SoumyadeepXD/prosthetic/hardware/diagrams/complete_wiring_diagram.png

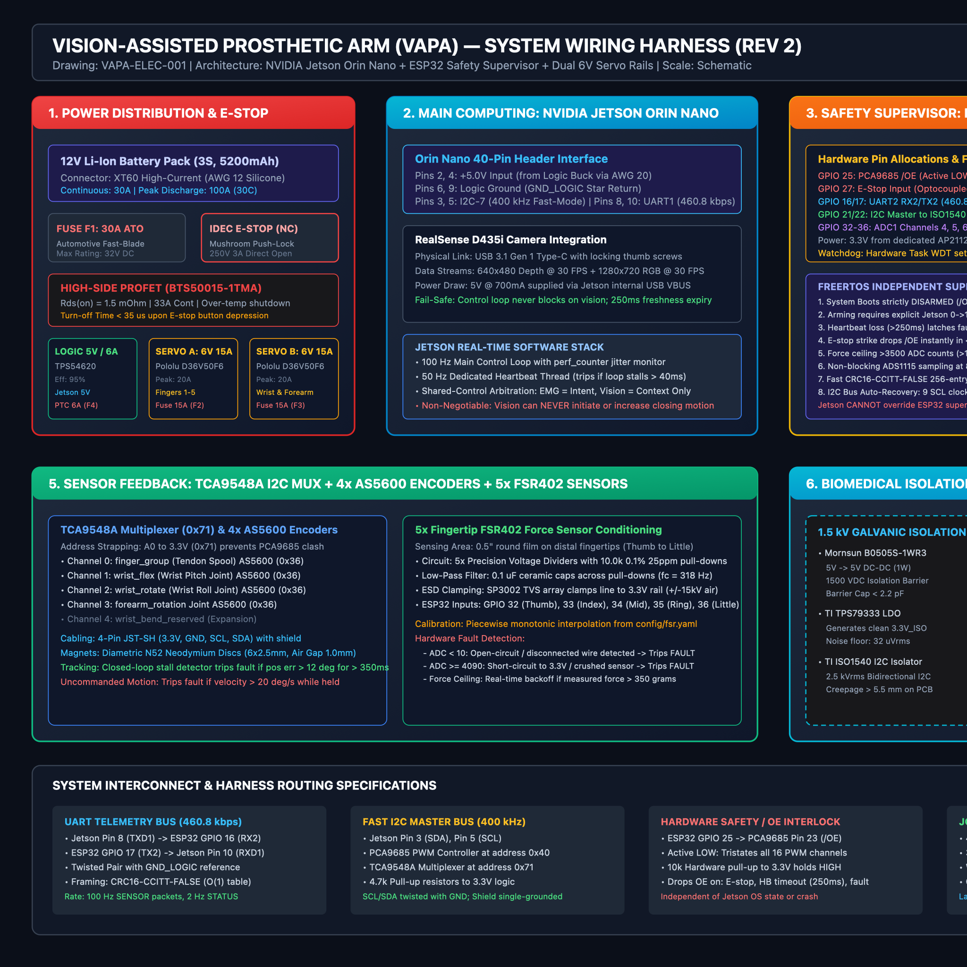
hardware/diagrams/complete_wiring_diagram.png
