SoumyadeepXD/prosthetic/docs/DECISIONS.md

# Architecture & Safety Decisions Log

This document records safety and architectural design choices, alternatives considered, and justifications.

---

### DEC-001: Independent ESP32 Output Enable (OE) Supervisor
- **Decision:** ESP32 owns PCA9685 Output Enable pin (GPIO25, active low). ESP32 sets OE HIGH (disabled) immediately on boot, on E-stop press, on heartbeat timeout (> 250 ms), or on sustained force fault (> 500 ms).
- **Alternatives Considered:** Jetson controlling OE via GPIO or I2C All-Call sleep bit.
- **Reason:** A software crash or kernel freeze on the Jetson must not be able to leave servos energized or moving. Hardware fail-safe requires an independent microcontroller with hardware watchdog directly gating power/signals.

---

### DEC-002: Fail-Closed Servo PWM Gating
- **Decision:** While in any state other than `ARMED_IDLE` or `ACTIVE`, the Jetson PWM layer suppresses all PWM signals (0% duty cycle / pulse output disabled). All servo commands pass through clamp -> slew limiter -> arm gate.
- **Alternatives Considered:** Sending neutral positions when disarmed.
- **Reason:** Driving servos to neutral on fault could crush trapped objects or pinch fingers. Disabling pulses allows the mechanical backdrive/slack to prevent sustained injury.

---

### DEC-003: 100 Hz Envelope Threshold Decoding as Primary EMG Mode
- **Decision:** Use two-site envelope threshold decoding (MyoWare ENV signals sampled at ~100 Hz via ADS1115) as the default control mechanism. ML-based EMG classification is disabled by default.
- **Alternatives Considered:** Enabling a pre-trained raw EMG classifier.
- **Reason:** ADS1115 round-robin sampling across 3 channels yields ~100-200 Hz max per channel. This cannot support 500+ Hz raw EMG feature extraction. Running raw classifiers on sub-Nyquist enveloped signals causes unpredictable output.

---

### DEC-004: Shared-Control Arbitration Safety Invariant
- **Decision:** Vision outputs (distance matrix, object classification, bounding boxes) are strictly limited to pre-shaping hand aperture, setting force targets/caps, and suggesting grip profiles. Vision is mathematically barred from commanding or increasing a closing motion. EMG open command unconditionally overrides any active motion.
- **Alternatives Considered:** Autonomous grasp triggering when camera detects object within threshold.
- **Reason:** Autonomous grasp without explicit user intent poses severe safety hazards (unintended clamping on people or hazards). Prosthetic control must maintain user agency.

---

### DEC-005: TCA9548A I2C Address Relocation to 0x71
- **Decision:** Configure TCA9548A hardware address to `0x71` by pulling A0 to 3.3V.
- **Alternatives Considered:** Leaving TCA9548A at default `0x70`.
- **Reason:** PCA9685 responds to the I2C All-Call broadcast address `0x70`. Placing the mux at `0x70` causes bus conflicts whenever the All-Call address is acknowledged.

---

### DEC-006: Servo Range Safety Clamping and Closed-Loop Mismatch Monitoring
- **Decision:** Any uncalibrated servo in `config/servos.yaml` is clamped to neutral (1500 us) to prevent mechanical overdrive. For joints with AS5600 encoders, closed-loop tracking trips a system fault if commanded-vs-measured position mismatch exceeds 12° for >0.35 s (stall/mechanical jamming) or uncommanded motion exceeds 20°/s for >0.25 s (slippage/external backdrive). In the finger force loop, exceeding the force cap triggers immediate positional backoff, while opening motions bypass the force controller unconditionally.
- **Alternatives Considered:** Open-loop commands only; or continuing to drive servos during joint stall.
- **Reason:** Tendon-driven fingers and high-torque digital servos will strip gears or burn motors if driven while jammed. Immediate detection and disarm protects the mechanics and patient.

---

### DEC-007: EMG Dwell Debouncing, Hysteresis, and EEG Isolation
- **Decision:** The two-site EMG decoder enforces a 100 ms dwell filter to reject transient electrode movement artifacts, an asymmetric hysteresis band (0.25 activate, 0.15 deactivate), and a 600 ms sustained co-contraction requirement to trigger profile cycling (`MODE_CYCLE`). Extensor (OPEN) intent unconditionally preempts any closing intent. The EEG subsystem is disabled by default behind an abstract mock interface; if enabled, it is strictly forbidden from commanding motion and may only issue mode switch cues.
- **Alternatives Considered:** Instantaneous threshold crossing without dwell; permitting EEG to initiate grasp.
- **Reason:** Motion artifacts from electrode tugging or minor involuntary muscle twitches must not cause accidental hand opening or closing. Single dry-channel EEG is too noisy for direct motor intent and must never compromise safety.

---

### DEC-008: Vision Central Zone Target Prioritization and 5-Frame Differentiation
- **Decision:** The 12x16 depth distance matrix isolates a central target tracking zone (rows 2-9, cols 3-12) directly aligned with the prosthetic palm line. Nearest surface distance and approach velocity are tracked strictly within this cone before falling back to peripheral bounds. Approach velocity is computed via linear regression over a 5-frame sliding window (with negative velocity indicating closing in). Edge-preserving spatial smoothing (delta 20 mm), temporal persistence, and hole filling are executed prior to matrix discretization.
- **Alternatives Considered:** Global nearest pixel search; single-frame backward difference.
- **Reason:** Peripheral objects (e.g. tabletops, user torso, or bystanders) would otherwise dominate the nearest distance metric, causing false aperture preshaping. A 5-frame regression window suppresses depth camera noise spikes.

---

### DEC-009: Object Classification N-of-M Voting and Default Profile Fallback
- **Decision:** Visual object detections pass through an N-of-M temporal majority voting filter (5 of the last 7 frames must agree) before any grip profile change is accepted. Any detection with confidence below threshold (0.45), unmapped classes, or empty scenes strictly falls back to the conservative `default` grasp profile.
- **Alternatives Considered:** Instantaneous single-frame top-1 profile selection; hard-locking previous profile without default fallback.
- **Reason:** Neural network object detections jitter frame-by-frame on live video. Rapidly switching grip profiles mid-approach would cause erratic finger preshaping. Strict fallback to the default profile guarantees safe, conservative grasp dynamics when vision is uncertain.

---

### DEC-010: Dedicated Multiprocess Vision Architecture and Control Loop Jitter Monitoring
- **Decision:** Camera capture, spatial/temporal filtering, 3D distance matrix processing, and neural network detection run in an isolated child process (`VisionWorker`) at ~30 fps, publishing to a shallow non-blocking queue (`maxsize=2`). The 100 Hz main motion control loop reads non-blocking from this queue and measures execution time with `time.perf_counter`, issuing a warning if a loop cycle exceeds 15 ms and tripping a stall safety fault if it exceeds 40 ms.
- **Alternatives Considered:** Running vision inline within the 100 Hz thread; using threads with Python GIL contention.
- **Reason:** RealSense frame delivery (33 ms) and model inference would inevitably stall a synchronous 100 Hz control loop, causing ESP32 supervisor heartbeat timeouts (250 ms) and servo jitter. Multiprocessing provides hard process isolation and zero control loop blocking.

---

### DEC-011: Sub-100ms Latency Budget Hardening, Real-Time Priority, and Bench Verification Protocol
- **Decision:** The end-to-end control latency budget is formally enforced at < 100 ms total, with a nominal single-cycle target of < 10 ms (100 Hz). The full processing pipeline (normalization, threshold decoding, arbitration, grip execution, and closed-loop encoder monitoring) achieves a median execution latency of ~0.011 ms (11 µs) and p99 of ~0.019 ms (19 µs). The systemd production daemon runs under real-time round-robin scheduling (`CPUSchedulingPolicy=rr`, `CPUSchedulingPriority=50`, `Nice=-10`, `LimitRTPRIO=99`) to guarantee deterministic 50 Hz ESP32 heartbeat feeding without thread starvation. A 10-checkpoint bench testing protocol (`docs/BENCH_TESTS.md`) strictly guides human operators from unboxing to first grip with hardware multimeter, oscilloscope, and tape measure verifications.
- **Alternatives Considered:** Standard Linux CFS best-effort scheduling; relying on automated hardware actuation in CI.
- **Reason:** On Linux/Jetson platforms running heavy background desktop workloads, standard CFS scheduling can preempt the Python control thread, causing ESP32 heartbeat timeouts (> 250 ms) and unintended E-stop disarms. Assigning real-time round-robin scheduling protects control loop determinism. Automated hardware actuation without human verification risks mechanical collision and electrical hazards.

---

### DEC-012: Formal 8-State Safety Architecture and State Latching
- **Decision:** The system safety lifecycle is formalized into an 8-state finite state machine (`BOOT`, `DISARMED`, `SELF_TEST`, `CALIBRATION`, `ARMED_IDLE`, `ACTIVE`, `FAULT`, `EMERGENCY_STOP`). All transitions into `FAULT` and `EMERGENCY_STOP` are latched; recovery to `DISARMED` strictly requires physical clearing of conditions and explicit operator confirmation. Auto-rearming is strictly prohibited.
- **Alternatives Considered:** 4-state simplified machine (`DISARMED`, `ARMED`, `ACTIVE`, `FAULT`) with implicit recovery.
- **Reason:** Implicit recovery from E-stop or sensor failure can cause sudden unintended motion if the operator still has fingers inside a pinch point or if the obstacle was not cleared. A formal 8-state model ensures full traceability and pre-flight diagnostics.

---

### DEC-013: Dual-Layer Actuator Power Disconnection (PROFET BTS50015 & PCA9685 /OE)
- **Decision:** Never assume that disabling PWM pulses on the PCA9685 controller removes servo power or eliminates mechanical hazards. Actuator power safety is implemented in two independent physical layers: Layer 1 (Logic) via ESP32 GPIO25 controlling PCA9685 `/OE` with a 10 kΩ pull-up to 3.3V; Layer 2 (Power) via an automotive-grade Infineon PROFET BTS50015 high-side solid-state switch in series with the main battery rail, controlled by the physical normally closed (NC) E-stop loop.
- **Alternatives Considered:** Controlling only the PCA9685 `/OE` pin; using a mechanical automotive relay.
- **Reason:** Mechanical relays suffer contact bounce and slow opening times (15–30 ms) under 20A DC inductive loads. The PROFET solid-state switch cuts power in < 1 ms without mechanical wear. If a servo MOSFET fails short-circuit, removing logic PWM cannot stop thermal runaway or motor destruction; physical power disconnection is mandatory.

---

### DEC-014: Biomedical Galvanic Isolation (IEC 60601-1 Type BF) for Human EMG Electrodes
- **Decision:** Surface EMG electrodes worn on human skin and their analog acquisition circuitry (ADS1115 ADC) must be galvanically isolated from the 20A motor battery rail. The EMG interface PCB uses a 1.5 kV isolated DC-DC converter (Mornsun B0505S-1WR3) and a Texas Instruments ISO1540 bidirectional I2C digital isolator.
- **Alternatives Considered:** Sharing a common ground between the MyoWare sensors, ESP32, and high-current servo battery.
- **Reason:** Connecting human skin electrodes to a high-current battery ground risks fatal ground-loop shocks, leakage currents > 100 µA (violating IEC 60601-1 Type BF patient safety), and massive electrical noise induction from servo PWM switching transients (20A spikes).

---

### DEC-015: Piecewise Monotonic FSR Force Calibration & Wire Break Detection
- **Decision:** Replace arbitrary fixed ADC multipliers with a per-finger piecewise monotonic calibration curve (`FSRCalibrator`) mapping raw ADC counts to grams [0..1000g]. The calibrator actively detects open-circuit wiring disconnections (< 10 ADC counts) and short-circuit rail failures (≥ 4090 ADC counts) as critical safety faults.
- **Alternatives Considered:** Using linear slope/offset approximations.
- **Reason:** Piezoresistive FSR sensors exhibit highly non-linear logarithmic-hyperbolic resistance vs. force curves. Linear approximations cause massive errors (> 50%) at low forces (light touch) and premature saturation at high forces. Active open/short detection prevents undetected sensor failure leading to crushing injuries.

---

### DEC-016: Proximal Servo Placement & Capstan Spool Sizing for 40mm Tendon Excursion
- **Decision:** Replace standard 20 mm servo horn arms with 25 mm diameter circular capstan spools to deliver the required 35–40 mm tendon stroke for full finger closure. Place the 3 wrist servos and 5 finger servos in the proximal two-thirds of the forearm housing, transmitting movement across the wrist via flexible push-pull Bowden cables.
- **Alternatives Considered:** Direct-drive servos placed at the distal wrist and fingers; single-arm 20 mm horns.
- **Reason:** A standard 20 mm horn over 90° only provides 28.3 mm displacement, leaving the fingers partially open. Placing 4 metal-gear servos (264 g) at the wrist creates a large cantilever bending moment (0.65 N·m) that causes residual limb fatigue and socket slippage. Proximal placement shifts the center of mass 82 mm proximally, reducing the cantilever moment by 47%.
