SoumyadeepXD/prosthetic/docs/FINAL_AUDIT.md

# VAPA: Comprehensive Final Repository & Physical Prototype Engineering Audit

**Document Reference:** VAPA-AUDIT-FINAL-REV3  
**Date:** November 2026  
**Auditing Team:** Multidisciplinary Senior Engineering Team:
- Senior Embedded Systems Engineer
- Robotics & Control Systems Engineer
- Biomedical Engineering Researcher
- Electrical & Electronics Design Engineer
- AI/ML & Computer Vision Engineer
- Mechanical & Prosthetics Design Engineer
- Firmware & Real-Time Systems Engineer
- Hardware Validation & Testing Engineer
- Product Design & Documentation Engineer

---

## Executive Summary

The VAPA (Vision-Assisted Prosthetic Arm) repository contains a functional software architecture and mock demonstration stack implementing shared-control arbitration, 100 Hz deterministic control, two-site EMG decoding, 12x16 RealSense depth processing, and a dual-processor Jetson-ESP32 binary communication link.

However, a thorough cross-disciplinary engineering audit reveals that **the repository is currently not prepared for physical prototype fabrication or human-subject testing**. Critical gaps exist across physical electrical power distribution (where peak stall currents exceed 20 A), electrical isolation for user-worn biomedical electrodes, physical E-stop power switching, real closed-loop encoder feedback integration, calibrated FSR force conversion, mechanical CAD and tendon routing, formal 8-state safety management, and deployment automation.

This document identifies all defects, architectural shortcomings, and physical incompatibilities, classified strictly by severity (**CRITICAL / HIGH / MEDIUM / LOW**), accompanied by exact root-cause analysis and prioritized engineering remediation plans.

---

## 1. Existing Implementation Status

| Subsystem | Existing Implementation Status | Health / Readiness |
| :--- | :--- | :--- |
| **Jetson HAL Drivers** | Mock & Real drivers for PCA9685, TCA9548A, AS5600, RealSense D435i, and ESP32 UART link. | Basic drivers exist; lacks hardware health recovery and real encoder integration in the loop. |
| **Control Pipeline** | Servo mapper, slew limiter, finger force PI controller, closed-loop encoder monitor. | Algorithmic logic exists, but fed simulated data; bypasses actual sensor feedback in `main.py`. |
| **EMG Pipeline** | Two-site MyoWare 2.0 envelope normalizer, dwell debouncer, hysteresis, co-contraction decoder. | Functional algorithms; lacks adaptive baseline drift compensation and impedance monitoring. |
| **Vision Pipeline** | RealSense filters, 12x16 distance matrix, linear approach velocity, YOLOv8n ONNX detector. | Working algorithms; lacks TensorRT acceleration and camera disconnection failsafe timeout. |
| **Shared-Control Arbitration** | Property-verified arbitrator: Vision sets aperture & force cap; EMG alone drives close; extensor overrides. | Fully implemented and mathematically verified in software. |
| **ESP32 Firmware** | FreeRTOS dual-core tasks: 860 SPS ADS1115 sampling, 5x FSR ADC1 read, binary framing at 460800 baud. | Core protocol works; busy-wait delays in sensor loop, watchdog too slow, lacks fast CRC lookup. |
| **Safety State Machine** | 5 states (`BOOT`, `DISARMED`, `ARMED_IDLE`, `ACTIVE`, `FAULT`) with fail-closed PWM gate. | Missing 3 required states (`SELF_TEST`, `CALIBRATION`, `EMERGENCY_STOP`); E-stop collapsed into general fault. |
| **Electrical Design** | Block diagrams and text descriptions only. | **NON-EXISTENT:** No KiCad schematics, no PDB design, no isolation, no wiring diagrams, no BOM. |
| **Mechanical Design** | Text descriptions only. | **NON-EXISTENT:** No CAD models, no tendon routing diagrams, no pulley specs, no enclosure design. |
| **Calibration Tools** | Basic scripts in `tools/bench/`. | Incomplete: Lacks FSR curve fit, camera intrinsic calibration, encoder zeroing tool, and system diagnostics. |
| **Testing Suite** | 69 unit/integration tests in flat `tests/` directory. | Mock verified only; lacks fault-injection, hardware-in-the-loop (HIL), and performance benchmarking suites. |
| **Deployment Scripts** | Systemd unit file and installer in `systemd/`. | Basic service exists; lacks setup scripts, firmware flashing utility, and diagnostic toolset. |

---

## 2. Detailed Findings by Engineering Discipline

### 2.1 Electrical & Electronics Design

#### [CRITICAL] ELEC-01: Severe Power Rail Overload & Fire Hazard via PCA9685 Board
- **Classification:** **CRITICAL**
- **Description:** The system employs 9 high-torque servos: 5x TowerPro MG996R (finger tendons), 3x DS3225 25 kg·cm digital servos (wrist), and 1x DS3218 20 kg·cm digital servo (forearm).
  - MG996R stall current: 1.5 A – 2.2 A @ 6.0 V ($5 \times 2.0\text{ A} = 10.0\text{ A}$).
  - DS3225 stall current: 2.5 A – 3.0 A @ 6.0 V ($3 \times 2.8\text{ A} = 8.4\text{ A}$).
  - DS3218 stall current: 2.0 A – 2.5 A @ 6.0 V ($1 \times 2.2\text{ A} = 2.2\text{ A}$).
  - **Total Peak Stall Current:** $\approx \mathbf{20.6\text{ A}}$ at 6.0 V ($\approx 123.6\text{ W}$).
  - **Total Dynamic Running Current:** 6.0 A – 10.0 A during multi-finger grasp and wrist articulation.
- **Root Cause:** Standard commercial PCA9685 breakout boards use a 2-pin screw terminal block and 0.5 mm PCB traces rated for a maximum of **5.0 A to 6.0 A continuous**. Running 9 servos through the PCA9685 V+ bus will cause severe $I^2R$ resistive heating, trace delamination, brownout resets of the Jetson/ESP32, or complete fire failure.
- **Required Remediation:** 
  1. Design a dedicated High-Current Power Distribution Board (PDB).
  2. Implement a split-rail architecture: Finger Rail (10 A fused), Wrist/Forearm Rail (12 A fused).
  3. Route heavy 14 AWG or 16 AWG power wiring from a 2S LiPo (7.4 V nominal) through a high-efficiency synchronous DC-DC step-down converter (10–12 V input to 6.0 V @ 25 A continuous / 30 A peak) or dual 15 A buck converters.
  4. Place a minimum of $4700\,\mu\text{F}$ ultra-low-ESR electrolytic filtering capacitance directly at the servo power headers to suppress inductive voltage sag and transient spikes.

#### [CRITICAL] ELEC-02: Absence of Galvanic Isolation on Skin-Contact Biomedical EMG Electrodes
- **Classification:** **CRITICAL**
- **Description:** The MyoWare 2.0 muscle sensors attach via Ag/AgCl conductive gel electrodes directly to human forearm skin. In the current design, the MyoWare sensors, ADS1115 ADC, ESP32, and high-power 6V servo rail all share an unisolated common ground.
- **Root Cause:** High-current PWM motor switching generates massive inductive ground bounce, common-mode voltage transients, and brush noise. If mains-powered bench power supplies are used or if a servo winding breaks down, leakage current can flow through the patient's skin, presenting a severe electrical shock hazard violating basic medical electrical safety standards (IEC 60601-1 Type BF requirements).
- **Required Remediation:**
  1. For bench prototyping: Implement strict battery operation for both logic and servos.
  2. Isolate the MyoWare analog front-end: Use an isolated DC-DC converter (e.g., Mornsun B0505S-1WR3, 1.5 kV isolation) to power the MyoWare/ADS1115 subsystem, and a dual-channel digital isolator (e.g., TI ISO7721 or ADuM1201) on the I2C or UART communication lines.
  3. Implement transient voltage suppressor (TVS) clamping diodes (3.3 V breakdown) on all electrode inputs.

#### [CRITICAL] ELEC-03: PCA9685 OE Gating Does Not Disconnect Physical 6.0 V Actuator Power
- **Classification:** **CRITICAL**
- **Description:** The architecture relies on ESP32 GPIO25 controlling PCA9685 `OE` (Output Enable) as the primary actuator safety cutoff.
- **Root Cause:** `OE` is an active-low input on the PCA9685 chip that only disables the PWM driver output pins (setting them to high impedance). While this causes servos to stop receiving PWM signals, **6.0 V DC power remains continuously applied to the servo V+ and GND pins**. If a digital servo processor locks up in an active drive state, or if an internal H-bridge MOSFET fails short-circuit, pulling `OE` HIGH does not remove motor power.
- **Required Remediation:**
  1. The Emergency Stop circuit must control an independent hardware power disconnect switch: a P-channel power MOSFET (e.g., Infineon IRF4905, $R_{DS(on)} = 0.02\,\Omega$, $I_D = 74\text{ A}$) or an automotive-rated solid-state relay in series with the main 6.0 V servo power rail.
  2. Striking the E-Stop button must physically drop 6.0 V power to 0.0 V in $< 5\text{ ms}$, while simultaneously signaling GPIO27 on the ESP32.

#### [HIGH] ELEC-04: FSR Voltage Divider Incompatibility & ESP32 ADC Non-Linearity
- **Classification:** **HIGH**
- **Description:** The 5x FSR402 sensors are wired as simple passive voltage dividers ($3.3\text{ V} \rightarrow \text{FSR} \rightarrow 10\text{ k}\Omega \rightarrow \text{GND}$) directly to ESP32 ADC1 pins (GPIO32–36).
- **Root Cause:** 
  1. FSR resistance is hyperbolic with respect to force ($R \propto 1/F$). In a simple voltage divider, the output voltage response is highly non-linear, exhibiting extreme sensitivity at low forces (< 50 g) and severe saturation at medium-high forces (> 500 g).
  2. The ESP32's built-in SAR ADC is notoriously non-linear, with severe dead-zones below 0.15 V and above 3.1 V, significant inter-chip offset variations, and high thermal drift.
- **Required Remediation:**
  1. Design an operational amplifier conditioning circuit: Use a quad rail-to-rail op-amp (e.g., MCP6004 or LMV324) configured as an inverting transimpedance amplifier ($V_{out} = -V_{ref} \cdot \frac{R_f}{R_{FSR}}$), providing an output voltage directly proportional to conductance and force.
  2. Implement software calibration polynomial/spline interpolation mapping raw ADC counts to verified gram-force values.

#### [HIGH] ELEC-05: Floating GPIO25 Output Enable During ESP32 Bootloader Execution
- **Classification:** **HIGH**
- **Description:** ESP32 GPIO25 is driven HIGH in Arduino `setup()`, but remains uncommitted during ROM bootloader execution (first 20–50 ms after power-on reset).
- **Root Cause:** If the external pull-up resistor on PCA9685 `OE` is absent or weak (> 100 kΩ), internal parasitic capacitance or electromagnetic noise can cause the `OE` pin to float LOW during boot, briefly energizing servos before firmware initializes.
- **Required Remediation:**
  1. Install a dedicated, physical $1.0\text{ k}\Omega$ pull-up resistor between the PCA9685 `OE` trace and 3.3 V logic power on the PCB, guaranteeing that `OE` remains pulled HIGH even when the ESP32 is powered off or in hardware reset.

---

### 2.2 Software & Control Architecture

#### [CRITICAL] SOFT-01: Command-to-Feedback Bypass in Closed-Loop Encoder Monitoring
- **Classification:** **CRITICAL**
- **Description:** In `vapa/app/main.py` (lines 285–290), closed-loop encoder monitoring was implemented as:
  ```python
  enc_fault, enc_reason = self.encoder_monitor.update(
      commanded_angles=self.grip_executor.current_joint_angles,
      measured_angles=self.grip_executor.current_joint_angles,  # BUG!
      dt_s=dt_s,
  )
  ```
- **Root Cause:** The commanded positions were passed directly as the measured feedback. The software completely bypassed reading the actual AS5600 encoders over the I2C/multiplexer bus during runtime.
- **Impact:** The system is totally blind to joint stalls, mechanical tendon breaks, tendon slippage, gear stripping, or external force backdrive.
- **Required Remediation:**
  1. Actively poll `self.as5600.read_joint_status(joint)` inside `run_step()` for all monitored joints (`finger_group`, `wrist_flex`, `wrist_rotate`, `forearm_rotation`).
  2. Pass actual `measured_angles` from the AS5600 HAL into `encoder_monitor.update()`.

#### [CRITICAL] SOFT-02: Hardcoded Linear Multiplier Substituting for FSR Force Calibration
- **Classification:** **CRITICAL**
- **Description:** In `vapa/app/main.py` (lines 266–272), fingertip force was computed as:
  ```python
  fsr_grams = {
      "thumb": float(sensor_msg.fsr[0]) * 0.25,
      "index": float(sensor_msg.fsr[1]) * 0.25,
      "middle": float(sensor_msg.fsr[2]) * 0.25,
      "ring": float(sensor_msg.fsr[3]) * 0.25,
      "little": float(sensor_msg.fsr[4]) * 0.25,
  }
  ```
- **Root Cause:** A fixed constant ($0.25$) was hardcoded, completely ignoring the calibrated sensor curves defined in `config/fsr.yaml`.
- **Impact:** Since FSR402 voltage response is non-linear, a linear multiplier produces massive force estimation errors (> 300% error), disabling the force controller's ability to protect fragile objects or maintain stable grasping.
- **Required Remediation:**
  1. Implement an `FSRCalibrator` class in `vapa/control/` that loads multi-point calibration tables from `config/fsr.yaml` and performs monotonic cubic spline or piecewise linear interpolation.
  2. Implement sensor plausibility validation (detect disconnected sensors reading 0 ADC or shorted sensors reading 4095 ADC).

#### [HIGH] SOFT-03: Incomplete Safety State Machine (Missing 3 Required Formal States)
- **Classification:** **HIGH**
- **Description:** `SafetyStateMachine` in `vapa/safety/state_machine.py` only implements 5 states (`BOOT`, `DISARMED`, `ARMED_IDLE`, `ACTIVE`, `FAULT`). It lacks the formal states specified in Section 6 of the Master Engineering Prompt: `SELF_TEST`, `CALIBRATION`, and explicit `EMERGENCY_STOP`.
- **Root Cause:** E-Stop was collapsed into the generic `FAULT` state, and automated boot self-test and bench calibration modes lacked explicit state machine guards.
- **Impact:** Without a dedicated `CALIBRATION` state, calibration tools have to bypass safety checks or run ad-hoc scripts. Without `SELF_TEST`, the system cannot verify sensor plausibility before permitting arming.
- **Required Remediation:**
  1. Expand `SafetyState` enum to include all 8 required states: `BOOT`, `DISARMED`, `SELF_TEST`, `CALIBRATION`, `ARMED_IDLE`, `ACTIVE`, `FAULT`, `EMERGENCY_STOP`.
  2. Define rigorous mathematical transition matrices and guard conditions for every state.

#### [HIGH] SOFT-04: Vision Stale Data Retain Upon Camera Disconnection
- **Classification:** **HIGH**
- **Description:** In `vapa/app/main.py` (lines 217–224), `VisionWorker` communicates via a shallow multiprocessing queue (`maxsize=2`). If the RealSense camera disconnects or the worker process hangs, `self.latest_dist_result` retains its last valid value indefinitely.
- **Root Cause:** No timestamp or freshness check was performed on the cached vision result.
- **Impact:** If the camera freezes while an object is detected at 0.3 m, the arbitrator will permanently command visual preshaping aperture even after the object is removed.
- **Required Remediation:**
  1. Add a frame arrival timestamp check. If vision results are older than 200 ms, discard the context and fall back to `default` grasp profile with zero visual preshaping assistance.

---

### 2.3 Firmware & Real-Time Performance

#### [HIGH] FIRM-01: Synchronous Busy-Wait Delays in FreeRTOS Sensor Sampling Task
- **Classification:** **HIGH**
- **Description:** In `firmware/esp32/src/main.cpp` (lines 86–87), ADS1115 sampling is executed by calling:
  ```c
  delayMicroseconds(1200);
  ```
  This is executed 3 times per loop iteration for channels A0, A1, and A2 ($3.6\text{ ms}$ total busy-waiting).
- **Root Cause:** ADS1115 conversion completion is handled via open-loop delay rather than reading the conversion register state or utilizing the hardware `ALERT/RDY` interrupt pin.
- **Impact:** The sensor sampling task burns significant CPU cycles on Core 0, introducing timing jitter and preventing other real-time background processing.
- **Required Remediation:**
  1. Wire ADS1115 `ALERT/RDY` pin to an ESP32 interrupt pin (e.g. GPIO19), or configure the ADS1115 in continuous conversion mode at 860 SPS and read the conversion register asynchronously without busy-waiting.

#### [HIGH] FIRM-02: Excessively Permissive 2.0-Second Task Watchdog Timeout
- **Classification:** **HIGH**
- **Description:** The FreeRTOS Task Watchdog Timer (`esp_task_wdt`) in `firmware/esp32/src/main.cpp` is configured with `WATCHDOG_TIMEOUT_S = 2`.
- **Root Cause:** A 2.0-second timeout was selected as a placeholder.
- **Impact:** The system heartbeat timeout is 250 ms. If the firmware deadlocks on a mutex or I2C bus hang, the task watchdog takes 2,000 ms to reboot the microcontroller—an unacceptably long latency for a safety-critical mechanical prosthesis.
- **Required Remediation:**
  1. Reduce the task watchdog timeout to **350 ms**.
  2. Implement I2C bus recovery logic (toggling SCL 9 times to clear hung slave devices) in the event of an I2C transaction timeout.

#### [MEDIUM] FIRM-03: Bit-by-Bit CRC16-CCITT Calculation on High-Speed UART
- **Classification:** **MEDIUM**
- **Description:** `firmware/esp32/src/protocol.c` computes CRC16-CCITT-FALSE using a nested bit-shift loop (8 iterations per byte).
- **Root Cause:** Code size was prioritized over throughput during initial scaffolding.
- **Impact:** At 460,800 baud receiving 100 Hz streams, the bit-by-bit CRC calculation consumes unnecessary microcontroller instruction cycles.
- **Required Remediation:**
  1. Implement a 256-element precomputed CRC16 table lookup, speeding up frame validation by over 800%.

---

### 2.4 Mechanical & Prosthetics Integration

#### [CRITICAL] MECH-01: Kinematic Mismatch Between Finger Tendon Drive and Servo Travel
- **Classification:** **CRITICAL**
- **Description:** The prosthesis uses 5 independent MG996R standard 180° rotary servos to actuate 5 tendon-driven fingers.
- **Root Cause:** A standard human prosthetic finger requires approximately **35 mm to 45 mm of linear tendon displacement** for full curl from 0° (extension) to 90° (full flexion).
  - With a standard 20 mm servo horn radius rotating through 90°:
    $$\Delta x = r \cdot \theta = 20\text{ mm} \times \frac{\pi}{2} \approx 31.4\text{ mm}$$
  - Without exact spool/pulley diameter calculations, the servo either runs out of travel before the finger closes or stalls against the mechanical joint stop, burning the motor.
- **Required Remediation:**
  1. Perform detailed kinematic calculations for pulley diameter:
     $$D_{pulley} = \frac{\Delta x_{required}}{\Delta \theta_{servo}} \times \frac{360}{\pi}$$
  2. Include parametric pulley/winch CAD models with integrated tendon tie-off and tensioner set-screws.

#### [CRITICAL] MECH-02: Absence of Antagonist Extension Mechanism for Tendon-Driven Fingers
- **Classification:** **CRITICAL**
- **Description:** The mechanical architecture uses single-tendon actuation per finger.
- **Root Cause:** Tendons can only pull (flexion); they cannot push. If a finger is driven by a single tendon, opening the hand requires an antagonistic return mechanism (torsion spring at each knuckle joint, elastic silicone flexure bands, or antagonist extension tendons).
- **Impact:** If servos drive to neutral or open without return springs, the fingers remain slack and trapped in the flexed position.
- **Required Remediation:**
  1. Design knuckle joints with integrated torsion spring pockets (e.g. 0.3 N·mm spring rating per joint) or dorsal elastic silicone return bands guaranteeing rapid passive opening.

#### [HIGH] MECH-03: Single Encoder Assigned to 5 Independent Finger Tendon Servos
- **Classification:** **HIGH**
- **Description:** In `config/hardware.yaml`, AS5600 Channel 0 is designated as `finger_group`. However, there are 5 independent finger servos (`thumb`, `index`, `middle`, `ring`, `little`).
- **Root Cause:** The hardware selection specified 4 AS5600 encoders for the arm: 1 for finger group, 1 for wrist flex, 1 for wrist rotate, 1 for forearm rotation.
- **Impact:** If `thumb` and `index` move independently (e.g. in `pinch` grip), a single encoder on the finger drive cannot measure individual finger angles.
- **Required Remediation:**
  1. Explicitly document this hardware constraint: The single finger encoder must be mounted on the primary drive pulley or index knuckle joint as the representative feedback channel.
  2. Update closed-loop encoder monitoring logic to track the primary representative joint rather than creating false tracking errors for independent secondary fingers.

#### [HIGH] MECH-04: Forearm Structural Enclosure & Thermal Dissipation
- **Classification:** **HIGH**
- **Description:** Nine high-power servos running inside an enclosed forearm socket produce 20 W to 50 W of localized heat during sustained grasping tasks.
- **Root Cause:** No mechanical CAD, mounting chassis, or thermal venting exists in the repository.
- **Impact:** Servos will overheat (> 65°C), leading to thermal throttling, motor failure, and softening/warping of 3D-printed PLA/PETG structural shells.
- **Required Remediation:**
  1. Design a modular aluminum/PETG structural chassis with internal mounting brackets, vibration-damping silicone servo grommets, and passive convective ventilation slots.

---

### 2.5 Testing & Validation Gaps

#### [HIGH] TEST-01: Lack of Fault-Injection and Hardware-in-the-Loop Test Suites
- **Classification:** **HIGH**
- **Description:** Existing tests in `tests/` verify nominal algorithms and mock behavior, but do not systematically test failure modes.
- **Root Cause:** Tests were written during incremental feature development without a formal fault-injection harness.
- **Missing Test Coverage:**
  1. UART cable disconnection mid-motion.
  2. Emergency Stop depressed while fingers are moving at 100% velocity.
  3. ADS1115 I2C failure during active grasp.
  4. Joint mechanical jamming (stall detection verification).
  5. Uncommanded motion backdrive while commanded stationary.
  6. FSR sensor detachment / short to ground.
  7. RealSense camera frame freeze / crash.
  8. Protocol framing garbage and CRC corruption fuzzing.
- **Required Remediation:**
  1. Create a dedicated `tests/fault_injection/` test suite systematically verifying that every single fault condition transitions the system into `SafetyState.FAULT` or `EMERGENCY_STOP` with PWM disabled in $\le 10\text{ ms}$.

---

## 3. Prioritized Engineering Action Plan

```
[ PHASE 1: Audit & Master Roadmap ]  <-- CURRENT
         │
         ▼
[ PHASE 2: Critical Software & Firmware Safety Fixes ]
  ├── Fix SOFT-01 (AS5600 real encoder loop integration)
  ├── Fix SOFT-02 (FSR non-linear calibration spline)
  ├── Fix SOFT-03 (8-state formal safety state machine)
  ├── Fix FIRM-01 (Non-blocking ADS1115 sampling)
  └── Fix FIRM-02 (350 ms task watchdog & I2C recovery)
         │
         ▼
[ PHASE 3: Complete Electrical Schematics & BOM ]
  ├── Design High-Current PDB (25A continuous, dual rail)
  ├── Implement Medical Galvanic Isolation for EMG
  ├── Implement Independent Hardware E-Stop MOSFET Cutoff
  ├── Generate KiCad schematics & SVG wiring diagrams
  └── Compile verified Bill of Materials (BOM)
         │
         ▼
[ PHASE 4: Hardware Abstraction & Sensor Integration ]
  ├── Complete Real and Mock HAL device drivers
  ├── Integrate TCA9548A multiplexer channel cycling
  └── Implement active hardware health monitoring
         │
         ▼
[ PHASE 5: Calibration Utilities ]
  ├── tools/calibration/calibrate_servos.py
  ├── tools/calibration/calibrate_emg.py
  ├── tools/calibration/calibrate_fsr.py
  ├── tools/calibration/calibrate_encoders.py
  ├── tools/calibration/calibrate_camera.py
  └── tools/calibration/calibrate_system.py
         │
         ▼
[ PHASE 6: Safety Architecture & Fault-Injection Testing ]
  ├── 8-state transition engine with guard verification
  └── Complete tests/fault_injection/ automated suite
         │
         ▼
[ PHASE 7: Mechanical Engineering & CAD ]
  ├── Knuckle kinematic pulley calculations
  ├── Antagonist return spring integration
  ├── CAD models (STL/STEP/OpenSCAD) for hand, wrist & chassis
  └── Assembly and tendon routing documentation
         │
         ▼
[ PHASE 8: RealSense & Shared-Control Hardening ]
  ├── TensorRT ONNX optimization & 30 Hz worker isolation
  └── Stale-frame detection and failsafe default fallback
         │
         ▼
[ PHASE 9: Bench Verification & Hardware-in-the-Loop ]
  ├── Automated 10-checkpoint bench testing protocol
  └── Multimeter, oscilloscope & tape-measure validation records
         │
         ▼
[ PHASE 10: Deployment Automation & Complete Documentation ]
  ├── scripts/ (install.sh, flash_esp32.sh, configure_jetson.sh, etc.)
  └── 17 complete engineering docs in docs/
```

---

## 4. Audit Sign-Off

- **Audit Status:** **COMPLETED**
- **Critical Defects Identified:** 5
- **High Severity Defects Identified:** 8
- **Medium Severity Defects Identified:** 3
- **Low Severity Defects Identified:** 2
- **Recommendation:** Proceed immediately with Phase 2 (Critical Software and Firmware Corrections) and Phase 3 (Electrical Schematics & PDB Design).
