SoumyadeepXD/prosthetic/hardware/bom/bill_of_materials.csv

Reference | Component | Manufacturer | Part Number | Package / Footprint | Electrical Specifications | Quantity | Subsystem | Unit Price (USD) | Supplier & Part No | Datasheet URL
U1 | NVIDIA Jetson Orin Nano Developer Kit | NVIDIA | 945-13766-0005-000 | Custom Module / Carrier | 7W - 15W mode; 6-core ARM; 20-40 TOPS; 40-pin GPIO | 1 | Main Computing | 499.00 | Arrow / 945-13766-0005-000 | https://developer.nvidia.com/embedded/jetson-orin-nano-developer-kit
CAM1 | Intel RealSense D435i Depth Camera | Intel | 999AFR | USB-C Enclosure | Active IR Stereo Depth + RGB + BMI055 IMU | 1 | Vision | 349.00 | Mouser / 675-999AFR | https://www.intelrealsense.com/depth-camera-d435i/
U2 | ESP32-WROOM-32E Microcontroller | Espressif Systems | ESP32-WROOM-32E-N4 | SMD Module 18x25.5mm | Dual-core 240MHz Xtensa LX6; 4MB SPI Flash; 3.3V | 1 | Safety Supervisor | 3.85 | DigiKey / 1965-ESP32-WROOM-32E-N4CT-ND | https://www.espressif.com/sites/default/files/documentation/esp32-wroom-32e_esp32-wroom-32ue_datasheet_en.pdf
U3 | PCA9685 16-Channel 12-Bit PWM Controller | NXP Semiconductors | PCA9685PW | TSSOP-28 | I2C Fast Mode+; 12-bit 40-1000Hz PWM; Active-LOW OE | 1 | Actuator Control | 2.45 | DigiKey / 568-10255-1-ND | https://www.nxp.com/docs/en/data-sheet/PCA9685.pdf
U4 | TCA9548A 8-Channel I2C Switch | Texas Instruments | TCA9548APWR | TSSOP-24 | 1.65V to 5.5V Bus; 400kHz; Hardware Reset; Addr 0x71 | 1 | Encoder Bus | 1.80 | DigiKey / 296-36873-1-ND | https://www.ti.com/lit/ds/symlink/tca9548a.pdf
U5 | ADS1115 16-Bit 860SPS 4-Ch Delta-Sigma ADC | Texas Instruments | ADS1115IDGSR | VSSOP-10 | 16-bit; Internal Reference; I2C; 860 samples/sec | 1 | Isolated Sensor | 4.10 | DigiKey / 296-24934-1-ND | https://www.ti.com/lit/ds/symlink/ads1115.pdf
U6 | ISO1540 Bidirectional I2C Digital Isolator | Texas Instruments | ISO1540DR | SOIC-8 | 2.5 kVrms isolation; Bidirectional SCL/SDA; 1MHz | 1 | Biomedical Isolation | 3.25 | DigiKey / 296-30354-1-ND | https://www.ti.com/lit/ds/symlink/iso1540.pdf
U7 | Medical Grade Isolated DC-DC Converter 5V->5V | Mornsun | B0505S-1WR3 | SIP-4 | 5Vin to 5Vout; 1W; 1500 VDC Isolation; 2pF barrier | 1 | Biomedical Isolation | 4.50 | Mouser / Mornsun B0505S-1WR3 | https://www.mornsun-power.com/public/uploads/pdf/B_S-1WR3.pdf
U8 | Low-Dropout 3.3V Voltage Regulator | Diodes Incorporated | AP2112K-3.3TRG1 | SOT-23-5 | Vin up to 6V; Vout 3.3V; 600mA; 250mV Dropout | 1 | ESP32 Logic Power | 0.45 | DigiKey / 31-AP2112K-3.3TRG1CT-ND | https://www.diodes.com/assets/Datasheets/AP2112.pdf
U9 | Isolated Ultra-Low-Noise 3.3V LDO | Texas Instruments | TPS79333DBVR | SOT-23-5 | Vin up to 5.5V; Vout 3.3V; 200mA; 32uVrms noise | 1 | Biomedical Isolation | 1.15 | DigiKey / 296-14436-1-ND | https://www.ti.com/lit/ds/symlink/tps79333.pdf
U10 | High-Side Power MOSFET E-Stop Interlock Switch | Infineon Technologies | BTS50015-1TMA | TO-263-7 (D2PAK) | 12V; 33A continuous; Rds(on) 1.5 mOhm; Current sense | 1 | Power Distribution | 6.20 | Mouser / 726-BTS500151TMA | https://www.infineon.com/dgdl/Infineon-BTS50015-1TMA-DataSheet-v01_00-EN.pdf
VR1 | 5V 6A Synchronous Step-Down DC-DC Converter | Texas Instruments | TPS54620RGYR | VQFN-14 | 4.5V-17V in; 5.0V out @ 6A; Integrated FETs; 95% eff | 1 | Power Distribution | 3.75 | DigiKey / 296-24953-1-ND | https://www.ti.com/lit/ds/symlink/tps54620.pdf
VR2 | 6V 15A Servo Rail A Buck Converter (Fingers) | Pololu / TI | D36V50F6 / LM5145 | Modular Module / QFN-20 | 6V to 40V in; 6.0V out @ 15A continuous / 20A peak | 1 | Power Distribution | 24.95 | Pololu / 4093 | https://www.pololu.com/product/4093
VR3 | 6V 15A Servo Rail B Buck Converter (Wrist/Arm) | Pololu / TI | D36V50F6 / LM5145 | Modular Module / QFN-20 | 6V to 40V in; 6.0V out @ 15A continuous / 20A peak | 1 | Power Distribution | 24.95 | Pololu / 4093 | https://www.pololu.com/product/4093
M1-M5 | MG996R Metal Gear Analog Servo | Tower Pro / Feetech | MG996R | Standard Servo 40.7x19.7x42.9mm | 4.8V-7.2V; 10 kg-cm; Stall 2.5A @ 6V; Deadband 5us | 5 | Hand Actuation | 12.50 | Direct / Adafruit 1142 | http://www.towerpro.com.tw/product/mg996r/
M6-M8 | DS3225 25kg Metal Gear Digital Servo | Dsservo | DS3225MG | Standard Servo 40x20.5x40.5mm | 4.8V-6.8V; 25 kg-cm; Stall 2.8A @ 6V; Waterproof IP66 | 3 | Wrist Actuation | 19.99 | Amazon / B076CNKQX4 | http://www.dsservo.com/
M9 | DS3218 20kg Metal Gear Digital Servo | Dsservo | DS3218MG | Standard Servo 40x20.5x40.5mm | 4.8V-6.8V; 20 kg-cm; Stall 2.2A @ 6V; 180 deg rotation | 1 | Forearm Actuation | 17.99 | Amazon / B0769DFJVK | http://www.dsservo.com/
S1-S4 | AS5600 12-Bit Magnetic Rotary Position Sensor | ams OSRAM | AS5600-ASOT | SOIC-8 | 12-bit (4096 pos); I2C Address 0x36; Magnet status reg | 4 | Joint Feedback | 2.65 | DigiKey / AS5600-ASOTCT-ND | https://ams.com/documents/20143/36005/AS5600_DS000365_5-00.pdf
MAG1-MAG4 | Diametric N52 Neodymium Disc Magnet | K&J Magnetics | D42-DIA | Cylinder 6mm OD x 2.5mm thick | Diametrically Magnetized; Grade N52; Remanence 1.48T | 4 | Joint Feedback | 1.45 | K&J Magnetics / D42-DIA | https://www.kjmagnetics.com/proddetail.asp?prod=D42-DIA
FSR1-FSR5 | FSR 402 Force Sensing Resistor | Interlink Electronics | 34-00015 | Circular 12.7mm OD | 0.2N to 20N range; Continuous analog resistance; 0.45mm | 5 | Fingertip Sensing | 8.95 | DigiKey / 1851-1002-ND | https://www.interlinkelectronics.com/fsr-402
EMG1-EMG2 | MyoWare 2.0 Muscle Sensor | Advancer Technologies / SparkFun | DEV-18977 | Custom Shield 37.6x37.6mm | Raw EMG + Envelope; 3.3V-5V; Snap Electrode interface | 2 | Biomedical Intent | 39.95 | SparkFun / DEV-18977 | https://www.sparkfun.com/products/18977
SW1 | Emergency Stop Pushbutton (Normally Closed) | IDEC | AB6E-3BV01PRM | Panel Mount 16mm | Push-lock turn-reset; 1 NC contact; 250V 3A; Red mushroom | 1 | Safety Interlock | 18.50 | DigiKey / 1885-1032-ND | https://www.idec.com/
F1 | Automotive Blade Fuse 30A (Main Battery Rail) | Littelfuse | 0257030.PXPV | ATO / ATC Blade | 32V DC; 30A fast-acting; Interrupting rating 1000A | 1 | Circuit Protection | 0.85 | DigiKey / F1762-ND | https://www.littelfuse.com/~/media/electronics/datasheets/fuses/littelfuse_fuse_257_datasheet.pdf
F2 | Automotive Blade Fuse 15A (Servo Rail A) | Littelfuse | 0257015.PXPV | ATO / ATC Blade | 32V DC; 15A fast-acting | 1 | Circuit Protection | 0.85 | DigiKey / F1756-ND | https://www.littelfuse.com/
F3 | Automotive Blade Fuse 15A (Servo Rail B) | Littelfuse | 0257015.PXPV | ATO / ATC Blade | 32V DC; 15A fast-acting | 1 | Circuit Protection | 0.85 | DigiKey / F1756-ND | https://www.littelfuse.com/
F4 | Resettable PTC Fuse 6A (Jetson 5V Rail) | Littelfuse | 16R600G | Radial Leaded | 16V; 6A hold; 12A trip; 0.01 Ohm | 1 | Circuit Protection | 1.10 | DigiKey / HF7060-ND | https://www.littelfuse.com/
C1-C4 | Low-ESR Aluminum Electrolytic Capacitor 2200uF 16V | Nichicon | UHW1C222MPD | Radial 12.5x25mm | 2200uF; 16V; Low ESR (0.016 Ohm); 3.1A ripple current | 4 | Power Decoupling | 1.35 | DigiKey / 493-11228-ND | https://www.nichicon.co.jp/
R1-R5 | Precision Metal Film Resistor 10.0k 0.1% | Vishay Beyschlag | MBA02040C1002BCT00 | Through Hole / 0204 | 10.0 kOhm; 0.1% tolerance; 25 ppm/C; 0.4W | 5 | FSR Divider | 0.42 | DigiKey / 541-10.0KBACT-ND | https://www.vishay.com/
TVS1-TVS5 | Bidirectional ESD Protection Diode 3.3V | Littelfuse | SP3002-04UTG | uDFN-10 | 3.3V reverse standoff; 0.85pF; IEC 61000-4-2 +/-15kV air | 2 | FSR / ADC Protection | 0.72 | DigiKey / F4712CT-ND | https://www.littelfuse.com/
CONN1 | Main Battery High-Current Connector XT60 Male | Amass | XT60H-M | In-line Cable Mount | 60A continuous / 100A peak; Gold plated brass; Polarity keyed | 1 | Power Wiring | 1.25 | Mouser / Amass XT60H | https://www.amasscn.com/
TB1-TB3 | High-Current PCB Screw Terminal Block 2-Pin 5.08mm | Phoenix Contact | 1729128 | Through Hole 5.08mm | 24A; 400V; Screw with wire protector; AWG 26-12 | 3 | Power Wiring | 1.85 | DigiKey / 277-1274-ND | https://www.phoenixcontact.com/
J1-J9 | 3-Pin Shrouded Servo Headers 2.54mm | Molex | 0022232031 | Through Hole 2.54mm (0.1") | GND - VDD - PWM; Friction lock; Gold plated pins | 9 | Servo Interconnect | 0.58 | DigiKey / WM4201-ND | https://www.molex.com/
J10-J13 | 4-Pin JST-SH Connector 1.0mm Pitch | JST | SM04B-SRSS-TB(LF)(SN) | SMD Right Angle 1.0mm | VCC - GND - SCL - SDA; Secure lock | 4 | Encoder Interconnect | 0.48 | DigiKey / 455-1804-1-ND | https://www.jst.com/
J14-J15 | 3-Pin JST-XH Connector 2.54mm Pitch | JST | B3B-XH-A(LF)(SN) | Through Hole 2.54mm | VCC_ISO - GND_ISO - ENV; Friction lock | 2 | EMG Interconnect | 0.32 | DigiKey / 455-1160-ND | https://www.jst.com/
J16-J20 | 2-Pin Molex Picoblade Connector 1.25mm | Molex | 0532610271 | SMD Right Angle 1.25mm | FSR Sensor Terminal Pins | 5 | FSR Interconnect | 0.45 | DigiKey / WM7620CT-ND | https://www.molex.com/
