SoumyadeepXD/prosthetic/hardware/schematics/emg_interface.kicad_sch

## KiCad design hardware/schematics/emg_interface.kicad_sch (2026-11-05)

Schematic: emg_interface.kicad_sch

Parts:
J14: MYOWARE_CH1_FLEXOR; JST_XH_B3B-XH-A_1x03_P2.50mm_Vertical
J15: MYOWARE_CH2_EXTENSOR; JST_XH_B3B-XH-A_1x03_P2.50mm_Vertical
J21: AUX_CRANIAL_EEG; JST_XH_B3B-XH-A_1x03_P2.50mm_Vertical
U5: ADS1115IDGSR; VSSOP-10_3x3mm_P0.5mm
U6: ISO1540DR; SOIC-8_3.9x4.9mm_P1.27mm
U7: B0505S-1WR3; Converter_DCDC_Mornsun_BxxxxS-1WR3_THT
U9: TPS79333DBVR; SOT-23-5

Notes on the sheet:
BIOMEDICAL ISOLATION BARRIER RULES: 1. Minimum 4.0 mm physical creepage and clearance distance between GND_LOGIC and GND_ISO. 2. No copper planes, traces, or vias allowed across the isolation moat. 3. Patient leakage current verified < 2.0 uA under single-fault conditions (SFC).
