SoumyadeepXD/prosthetic/hardware/schematics/encoder_interface.kicad_sch

## KiCad design hardware/schematics/encoder_interface.kicad_sch (2026-11-05)

Schematic: encoder_interface.kicad_sch

Parts:
C12: 0.1uF_X7R
J10: ENC_FINGER_GROUP_AS5600; JST_SH_SM04B-SRSS-TB_1x04-1MP_P1.00mm_Horizontal
J11: ENC_WRIST_FLEX_AS5600; JST_SH_SM04B-SRSS-TB_1x04-1MP_P1.00mm_Horizontal
J12: ENC_WRIST_ROTATE_AS5600; JST_SH_SM04B-SRSS-TB_1x04-1MP_P1.00mm_Horizontal
J13: ENC_FOREARM_ROT_AS5600; JST_SH_SM04B-SRSS-TB_1x04-1MP_P1.00mm_Horizontal
RP1: 4x4.7k_SDA_PULLUPS
RP2: 4x4.7k_SCL_PULLUPS
U4: TCA9548APWR; TSSOP-24_4.4x7.8mm_P0.65mm

Notes on the sheet:
I2C ADDRESSING SPECIFICATION: 1. A0 is tied to 3.3V, A1/A2 to GND -> Base address is 0x71. 2. This strictly prevents collisions with the PCA9685 default All-Call address (0x70). 3. Each AS5600 has fixed hardware address 0x36 and is isolated behind its dedicated mux channel.
