SoumyadeepXD/prosthetic/hardware/schematics/esp32_controller.kicad_sch

## KiCad design hardware/schematics/esp32_controller.kicad_sch (2026-11-05)

Schematic: esp32_controller.kicad_sch

Parts:
C5: 10uF_X7R
C6: 0.1uF_X7R
R6: 10k_0.1%
R7: 4.7k_SDA
R8: 4.7k_SCL
U2: ESP32-WROOM-32E-N4; ESP32-WROOM-32E
U11: PC817_OPTO; DIP-4_W7.62mm

Notes on the sheet:
CRITICAL SAFETY HARDWARE CONFIGURATION: 1. GPIO25 is driven HIGH immediately upon boot to keep PCA9685 tristated. 2. R6 (10k pull-up) guarantees /OE remains HIGH even if ESP32 is unpowered or held in reset. 3. GPIO27 optocoupler triggers hardware interrupt on contact break (< 100 us shutdown latenc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
