SoumyadeepXD/prosthetic/hardware/schematics/fsr_interface.kicad_sch

## KiCad design hardware/schematics/fsr_interface.kicad_sch (2026-11-05)

Schematic: fsr_interface.kicad_sch

Parts:
C7, C8, C9, C10, C11: 0.1uF_X7R
J16: FSR_THUMB_CONN; Molex_PicoBlade_53261-0271_1x02-1MP_P1.25mm_Horizontal
J17: FSR_INDEX_CONN; Molex_PicoBlade_53261-0271_1x02-1MP_P1.25mm_Horizontal
J18: FSR_MID_CONN; Molex_PicoBlade_53261-0271_1x02-1MP_P1.25mm_Horizontal
J19: FSR_RING_CONN; Molex_PicoBlade_53261-0271_1x02-1MP_P1.25mm_Horizontal
J20: FSR_LITTLE_CONN; Molex_PicoBlade_53261-0271_1x02-1MP_P1.25mm_Horizontal
R1, R2, R3, R4, R5: 10.0k_0.1%
TVS1, TVS2, TVS3, TVS4, TVS5: SP3002_3.3V

Notes on the sheet:
FSR VOLTAGE DIVIDER CIRCUIT NOTES: 1. 10.0k 0.1% 25ppm metal-film pull-downs provide excellent temperature stability. 2. 0.1 uF capacitor gives low-pass cutoff fc = 318 Hz, rejecting 20 kHz PWM motor switching hash. 3. TVS diodes prevent ESD from static build-up on fingertip touch from damaging ESP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
