SoumyadeepXD/prosthetic/hardware/schematics/power_distribution.kicad_sch

## KiCad design hardware/schematics/power_distribution.kicad_sch (2026-11-05)

Schematic: power_distribution.kicad_sch

Parts:
C1, C2, C3, C4: 2200uF_16V_LOW_ESR
CONN1: XT60_BATTERY_12V; AMASS_XT60-M
F1: 30A_ATO_BLADE; Fuseholder_Blade_ATO_Littelfuse_FHAC0001
F2, F3: 15A_ATO_BLADE
F4: 6A_PTC_RESETTABLE
SW1: IDEC_ESTOP_NC; IDEC_AB6E-3BV01PRM
U8: AP2112K-3.3; SOT-23-5
U10: BTS50015-1TMA; TO-263-7_TabPin8
VR1: TPS54620_5V_6A; Texas_RGY0014B
VR2, VR3: D36V50F6_6V_15A

Notes on the sheet:
STAR GROUND JUNCTION POINT: GND_POWER and GND_LOGIC tie together at XT60 (-) terminal shunt. No high-current motor return currents flow through logic ground plane.
