SoumyadeepXD/prosthetic/hardware/schematics/servo_controller.kicad_sch

## KiCad design hardware/schematics/servo_controller.kicad_sch (2026-11-05)

Schematic: servo_controller.kicad_sch

Parts:
J1: SERVO_THUMB_MG996R; PinHeader_1x03_P2.54mm_Vertical
J2: SERVO_INDEX_MG996R; PinHeader_1x03_P2.54mm_Vertical
J3: SERVO_MIDDLE_MG996R; PinHeader_1x03_P2.54mm_Vertical
J4: SERVO_RING_MG996R; PinHeader_1x03_P2.54mm_Vertical
J5: SERVO_LITTLE_MG996R; PinHeader_1x03_P2.54mm_Vertical
J6: SERVO_WRIST_PITCH_DS3225; PinHeader_1x03_P2.54mm_Vertical
J7: SERVO_WRIST_ROLL_DS3225; PinHeader_1x03_P2.54mm_Vertical
J8: SERVO_WRIST_DEV_DS3225; PinHeader_1x03_P2.54mm_Vertical
J9: SERVO_FOREARM_ROT_DS3218; PinHeader_1x03_P2.54mm_Vertical
U3: PCA9685PW; TSSOP-28_4.4x9.7mm_P0.65mm

Notes on the sheet:
PCA9685 HARDWARE NOTES: 1. A0-A5 strapped to GND -> I2C address 0x40. 2. ALLCALL mode disabled in software at startup to avoid I2C broadcast lockups. 3. /OE (Pin 23) active LOW. When HIGH, all outputs are tristated to high-Z.
