SoumyadeepXD/prosthetic/config/servos.yaml

servos:
  thumb:
    channel: 0
    model: MG996R
    pulse_min_us: 1000
    pulse_neutral_us: 1500
    pulse_max_us: 2000
    angle_min_deg: 0.0
    angle_max_deg: 90.0
    direction: 1
    max_slew_rate_deg_s: 180.0
    home_position: 0.0
    calibrated: true
  index:
    channel: 1
    model: MG996R
    pulse_min_us: 1000
    pulse_neutral_us: 1500
    pulse_max_us: 2000
    angle_min_deg: 0.0
    angle_max_deg: 90.0
    direction: 1
    max_slew_rate_deg_s: 180.0
    home_position: 0.0
    calibrated: true
  middle:
    channel: 2
    model: MG996R
    pulse_min_us: 1000
    pulse_neutral_us: 1500
    pulse_max_us: 2000
    angle_min_deg: 0.0
    angle_max_deg: 90.0
    direction: 1
    max_slew_rate_deg_s: 180.0
    home_position: 0.0
    calibrated: true
  ring:
    channel: 3
    model: MG996R
    pulse_min_us: 1000
    pulse_neutral_us: 1500
    pulse_max_us: 2000
    angle_min_deg: 0.0
    angle_max_deg: 90.0
    direction: 1
    max_slew_rate_deg_s: 180.0
    home_position: 0.0
    calibrated: true
  little:
    channel: 4
    model: MG996R
    pulse_min_us: 1000
    pulse_neutral_us: 1500
    pulse_max_us: 2000
    angle_min_deg: 0.0
    angle_max_deg: 90.0
    direction: 1
    max_slew_rate_deg_s: 180.0
    home_position: 0.0
    calibrated: true
  wrist_flex:
    channel: 5
    model: DS3225
    pulse_min_us: 1000
    pulse_neutral_us: 1500
    pulse_max_us: 2000
    angle_min_deg: -45.0
    angle_max_deg: 45.0
    direction: 1
    max_slew_rate_deg_s: 90.0
    home_position: 0.0
    calibrated: true
  wrist_rotate:
    channel: 6
    model: DS3225
    pulse_min_us: 1000
    pulse_neutral_us: 1500
    pulse_max_us: 2000
    angle_min_deg: -90.0
    angle_max_deg: 90.0
    direction: 1
    max_slew_rate_deg_s: 90.0
    home_position: 0.0
    calibrated: true
  wrist_bend:
    channel: 7
    model: DS3225
    pulse_min_us: 1000
    pulse_neutral_us: 1500
    pulse_max_us: 2000
    angle_min_deg: -30.0
    angle_max_deg: 30.0
    direction: 1
    max_slew_rate_deg_s: 60.0
    home_position: 0.0
    has_encoder: false
    calibrated: true
  forearm_rotation:
    channel: 8
    model: DS3218
    pulse_min_us: 1000
    pulse_neutral_us: 1500
    pulse_max_us: 2000
    angle_min_deg: -90.0
    angle_max_deg: 90.0
    direction: 1
    max_slew_rate_deg_s: 90.0
    home_position: 0.0
    calibrated: true
