SoumyadeepXD/prosthetic/config/fsr.yaml

sensors:
  thumb:
    pin: 32
    baseline_raw: 50
    noise_margin: 80
    max_raw: 3450
    calibration_points:
    - - 50
      - 0.0
    - - 320
      - 50.0
    - - 950
      - 150.0
    - - 1850
      - 300.0
    - - 2650
      - 500.0
    - - 3450
      - 1000.0
    calibrated: true
  index:
    pin: 33
    baseline_raw: 50
    noise_margin: 80
    max_raw: 3450
    calibration_points:
    - - 50
      - 0.0
    - - 320
      - 50.0
    - - 950
      - 150.0
    - - 1850
      - 300.0
    - - 2650
      - 500.0
    - - 3450
      - 1000.0
    calibrated: true
  middle:
    pin: 34
    baseline_raw: 50
    noise_margin: 80
    max_raw: 3450
    calibration_points:
    - - 50
      - 0.0
    - - 320
      - 50.0
    - - 950
      - 150.0
    - - 1850
      - 300.0
    - - 2650
      - 500.0
    - - 3450
      - 1000.0
    calibrated: true
  ring:
    pin: 35
    baseline_raw: 50
    noise_margin: 80
    max_raw: 3450
    calibration_points:
    - - 50
      - 0.0
    - - 320
      - 50.0
    - - 950
      - 150.0
    - - 1850
      - 300.0
    - - 2650
      - 500.0
    - - 3450
      - 1000.0
    calibrated: true
  little:
    pin: 36
    baseline_raw: 50
    noise_margin: 80
    max_raw: 3450
    calibration_points:
    - - 50
      - 0.0
    - - 320
      - 50.0
    - - 950
      - 150.0
    - - 1850
      - 300.0
    - - 2650
      - 500.0
    - - 3450
      - 1000.0
    calibrated: true
force_control:
  default_target_grams: 150.0
  default_cap_grams: 350.0
  fragile_cap_grams: 120.0
