SoumyadeepXD/prosthetic/(commit log)

2026-10-28 Phase 0: Complete audit, repository scaffold, Rev 2 configs, and test harness
    [hardware.yaml, servos.yaml]
2026-10-28 Phase 2: Complete Jetson HAL implementation, unwrapping, factory, and bench tools
    [hardware.yaml]
2026-10-28 Phase 3: Safety state machine, PWM gate, preconditions, and exception handling
2026-10-28 feat(control): complete Phase 4 servo control, closed loop encoder monitoring, and calibration bench tool
2026-10-28 feat(emg): complete Phase 5 envelope handling, two-site decoder, calibration tool, and classifier interface
2026-10-28 feat(vision): complete Phase 6 RealSense depth pipeline, filters, 12x16 distance matrix, and offline replay harness
2026-10-28 feat(vision): complete Phase 7 object detection integration, class-to-profile mapping, and N-of-M voting filter
2026-10-28 feat(fusion): complete Phase 8 shared-control arbitration, 100 Hz control loop, 30 Hz multiprocess vision worker, and 800x480 status UI
2026-11-05 feat(phase-2): complete critical software and firmware corrections
    - Implement formal 8-state safety architecture (BOOT, DISARMED, SELF_TEST, CALIBRATION, ARMED_IDLE, ACTIVE, FAULT, EMERGENCY_STOP)
    - Add non-linear FSR402 piecewise calibration with open/short fault detection
    - Close encoder feedback loop with real AS5600 readings and mock dynamic simulator
    - Add vision freshness timeout (>250ms invalidation) and physical E-stop latching in main control loop
    - Optimize ESP32 firmware with non-blocking ADS1115 sampling, I2C bus recovery, 350ms watchdog, and O(1) CRC16 lookup table
    - Add unit tests for 8-state safety transitions, E-stop overrides, and FSR calibration
    [as5600.py, fsr_calibrator.py, main.cpp, main.py, protocol.h, test_fsr_calibrator.py, test_safety.py]
2026-11-05 feat(phase-3): complete electronics and circuit design package
    - Add complete KiCad schematics (vapa_main, power_distribution, esp32_controller, servo_controller, emg_interface, fsr_interface, encoder_interface)
    - Add complete system wiring diagrams (SVG vector and 2048px PNG)
    - Add power distribution and real-time signal flow architectural diagrams
    - Add comprehensive Bill of Materials (BOM) CSV and engineering component specifications with current and thermal budget analysis
    - Add harness pinouts, fabrication instructions, star-grounding architecture, and IEC 60601-1 Type BF biomedical galvanic isolation documentation
    [emg_interface.kicad_sch, encoder_interface.kicad_sch, esp32_controller.kicad_sch, fsr_interface.kicad_sch, power_distribution.kicad_sch, servo_controller.kicad_sch, vapa_main.kicad_sch]
2026-11-05 feat(phase-4): harden hardware abstraction layer with auto-reconnect and error recovery
    - Implement automatic serial reconnection with exponential backoff in RealESPLink
    - Add I2C bus write recovery and retry logic in RealTCA9548A with redundant switch avoidance
    - Add I2C bus retry and error recovery in RealPCA9685
    [esp_link.py, pca9685.py, tca9548a.py]
2026-11-05 feat(phase-5): complete calibration framework and bench tools
    [calibration_certificate.yaml, camera_calibration.yaml, hardware.yaml, servos.yaml]
2026-11-05 feat(phase-7): complete mechanical prosthetic design, kinematics, and manufacturing specifications
2026-11-05 fix(bom): track electrical and mechanical bill of materials csv files
    [bill_of_materials.csv, bill_of_materials_mechanical.csv]
